purdue-orbital/balloon/boards/node_prototype/notes.md

# pending
- move ISP header away from relay
- keep ISP header close enough to power jumper so the jumper must be disconnected first
- fix regulator heatsink short
- break out radio serial to header
- disconnect reset pin on attiny84
