purdue-orbital/balloon/code/modem/simulation/modulation_coherent.png

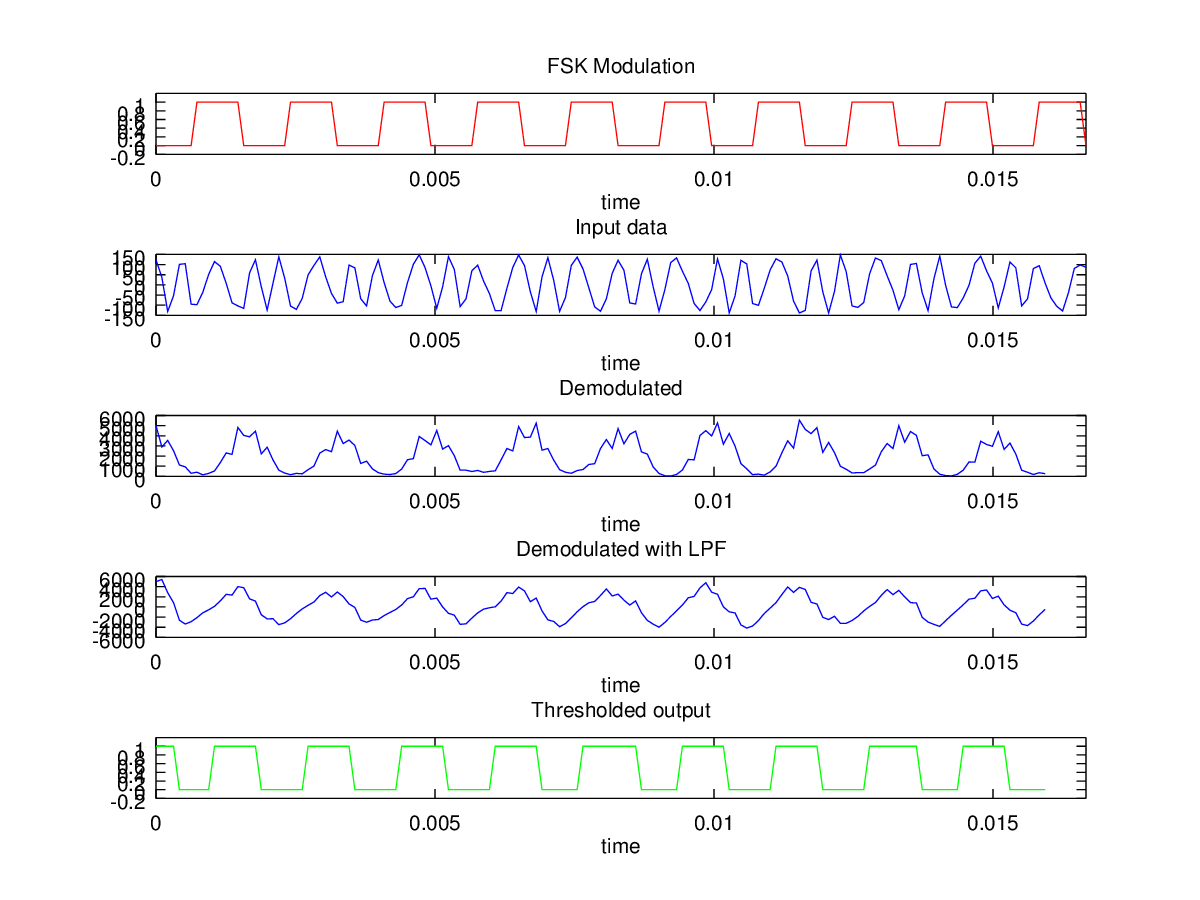
code/modem/simulation/modulation_coherent.png
