purdue-orbital/balloon/code/modem/simulation/modulation_coherent_noise5.png

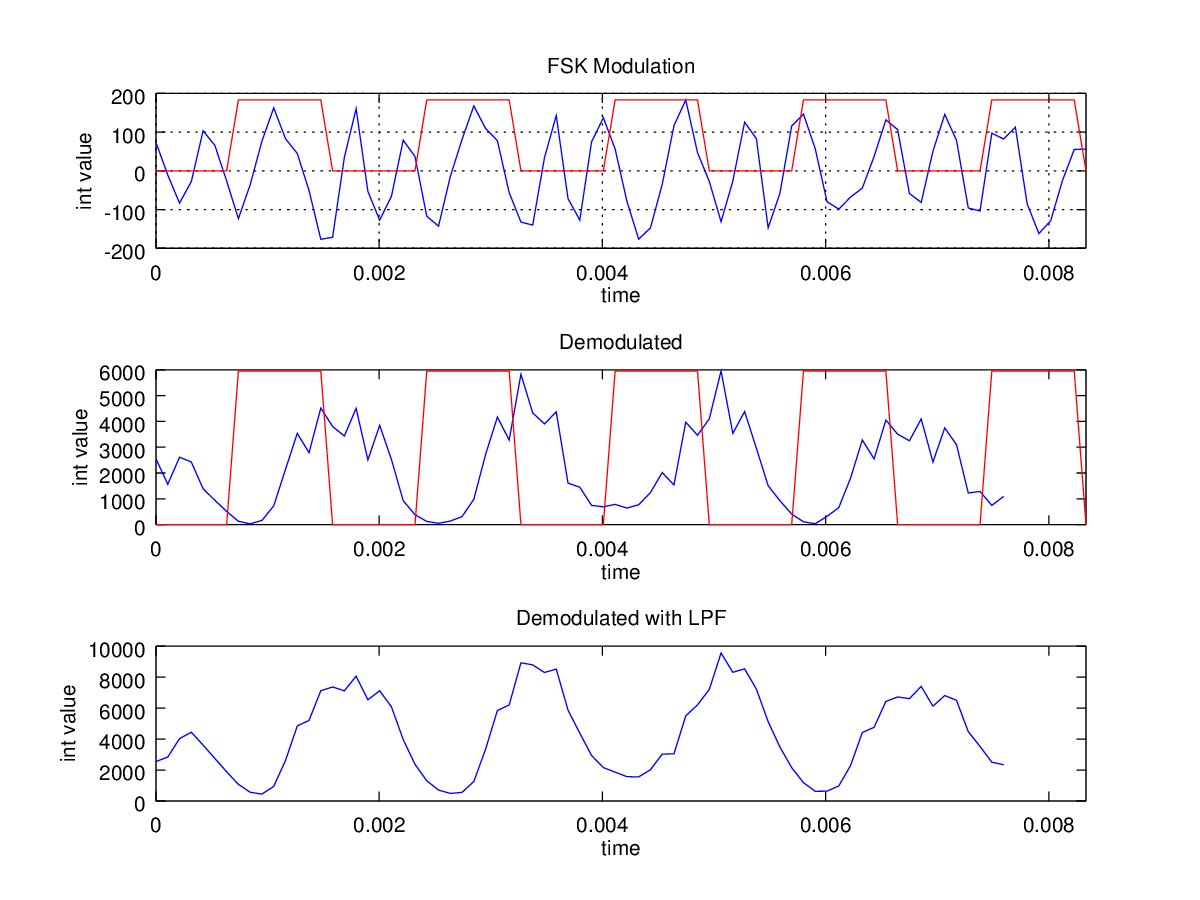
code/modem/simulation/modulation_coherent_noise5.png
