purdue-orbital/balloon/code/modem/simulation/modulation_coherent_noise25.png

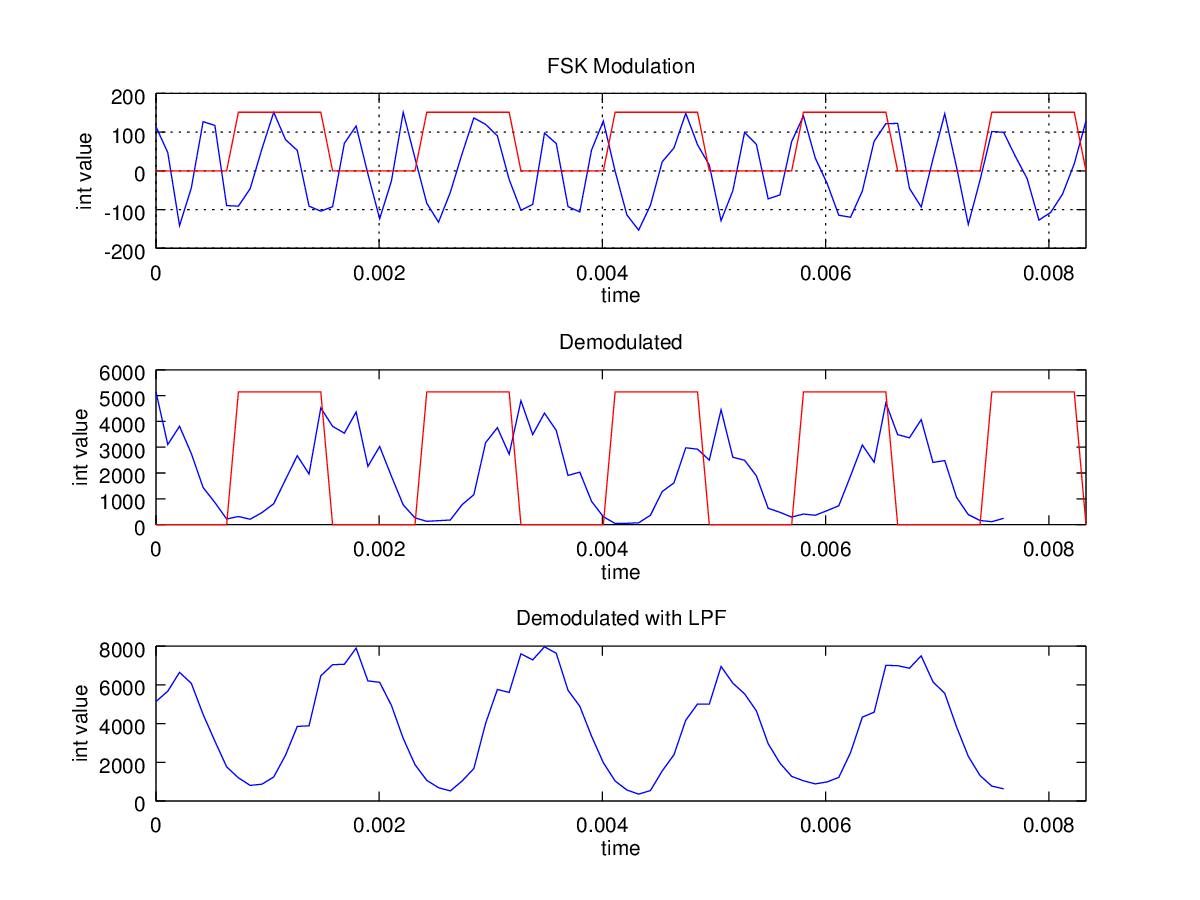
code/modem/simulation/modulation_coherent_noise25.png
