purdue-orbital/balloon/code/modem/simulation/modulation_incoherent.png

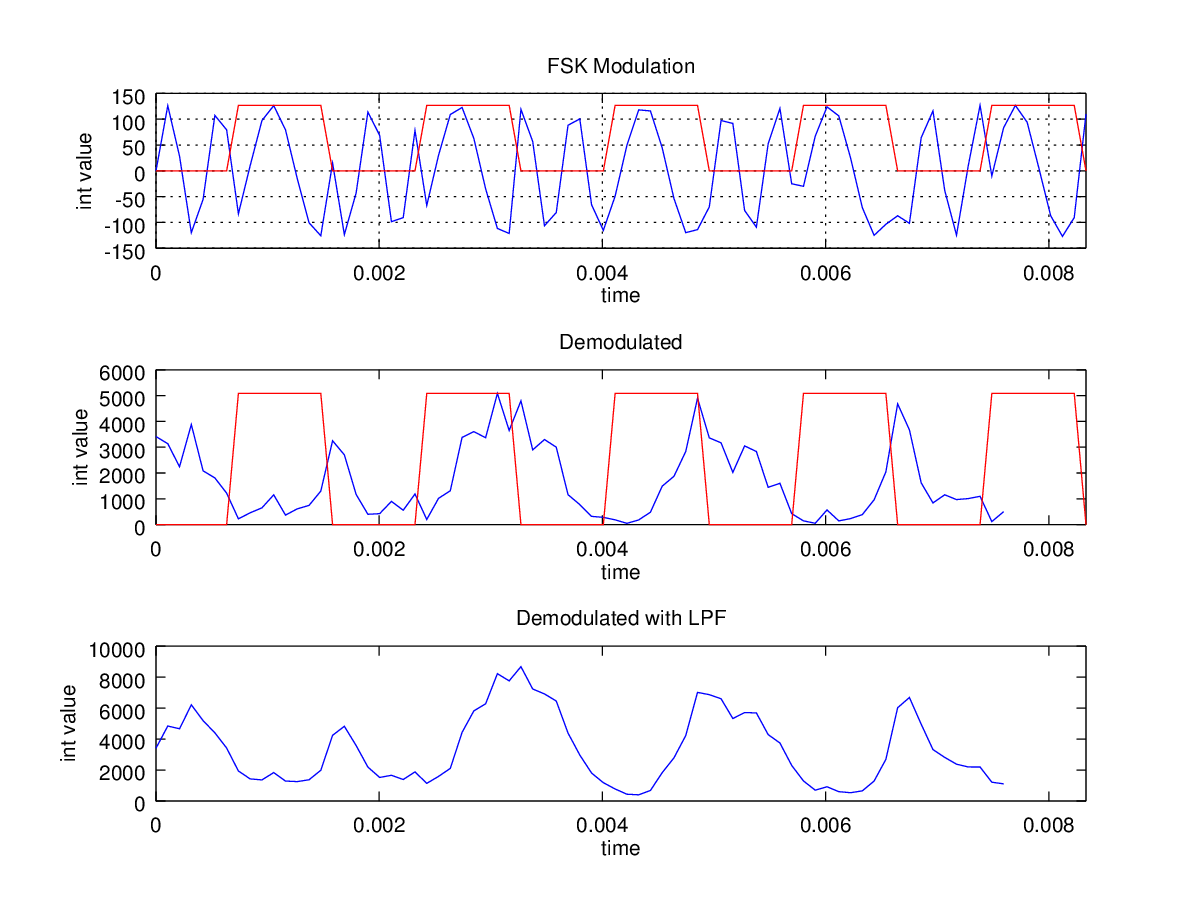
code/modem/simulation/modulation_incoherent.png
