purdue-orbital/balloon/code/modem/simulation/spectrogram_coherent.png

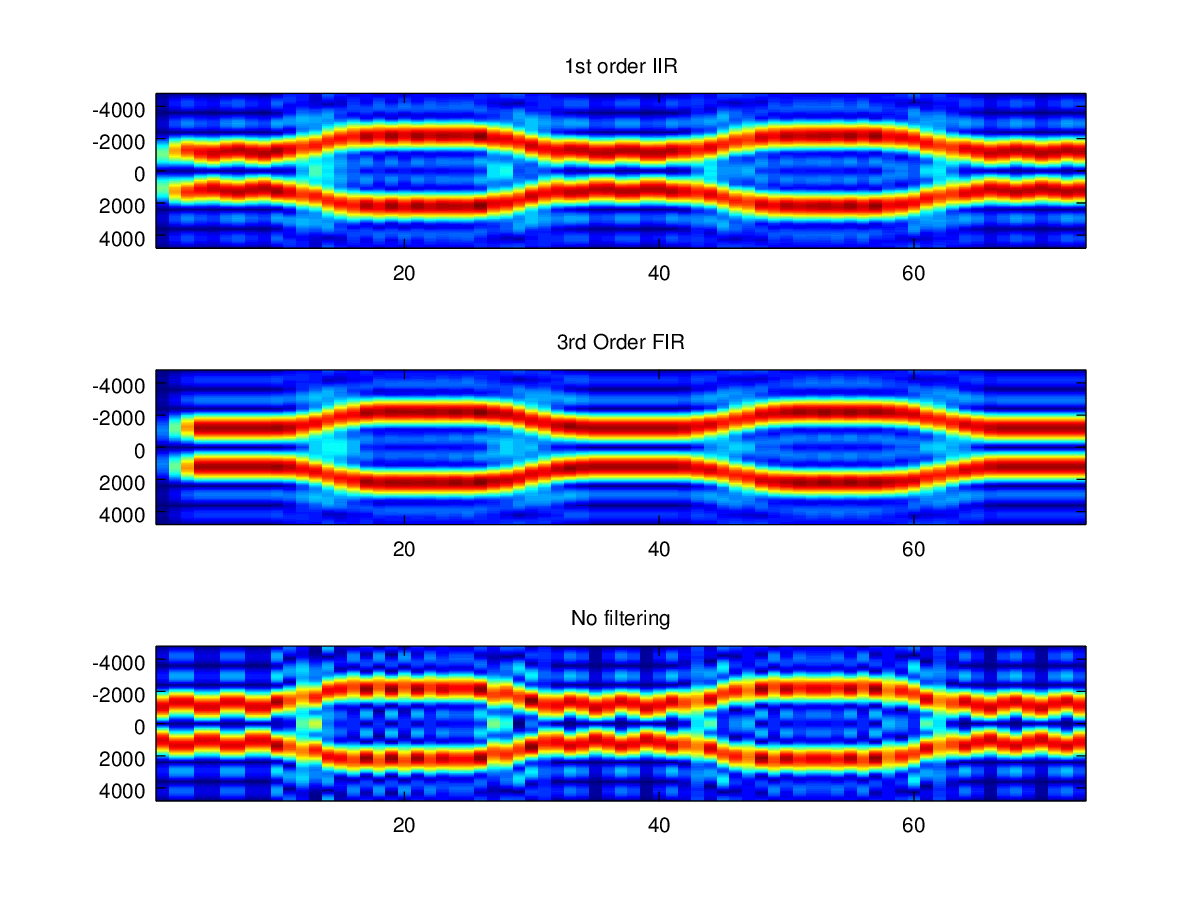
code/modem/simulation/spectrogram_coherent.png
