purdue-orbital/balloon/code/modem/simulation/spectrogram_incoherent.png

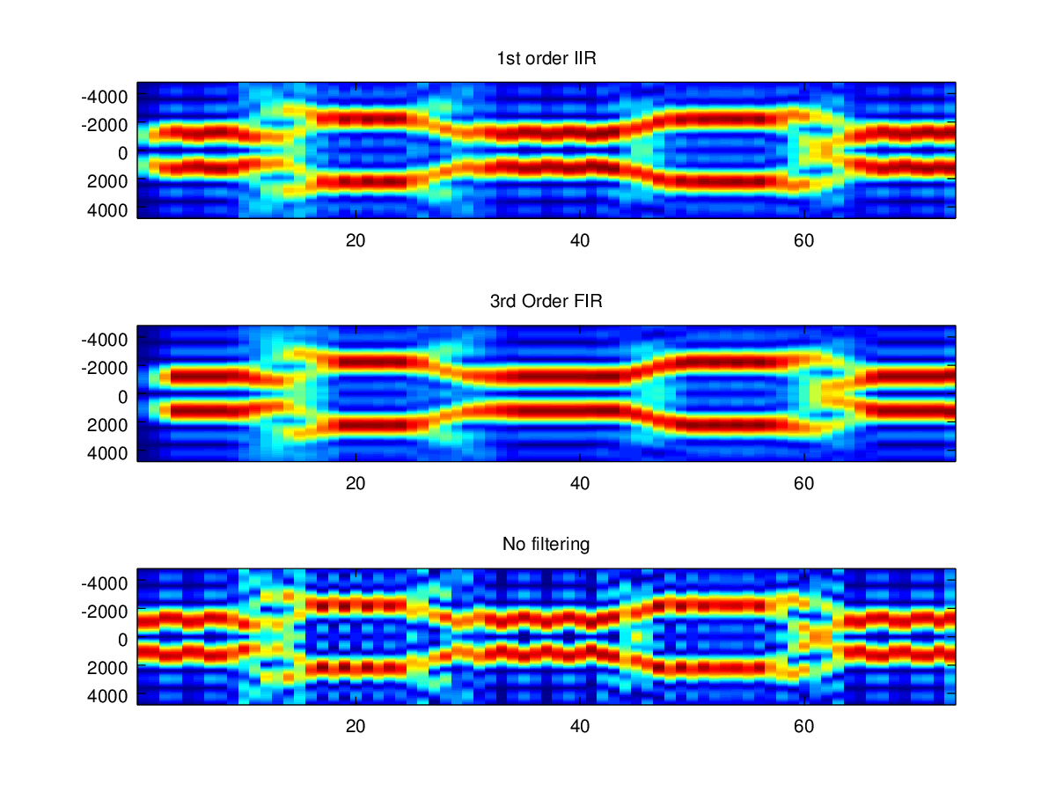
code/modem/simulation/spectrogram_incoherent.png
