purdue-orbital/balloon/boards/node_prototype/bom.md

| Part             | # Needed | # To Buy | Unit Cost | Link                                                                                                     |
|------------------+----------+----------+-----------+----------------------------------------------------------------------------------------------------------|
| ATTiny85         |        2 |        0 |           |                                                                                                          |
| 0.1uF            |        5 |        0 |           |                                                                                                          |
| 1uF              |        3 |        0 |           |                                                                                                          |
| 10uF             |        1 |        0 |           |                                                                                                          |
| DRA818V          |        1 |        0 |           |                                                                                                          |
| SMA Conn         |        1 |        0 |           |                                                                                                          |
| 2n2222           |        1 |        0 |           |                                                                                                          |
| Omron G5LE Relay |        1 |       10 |      1.41 | http://www.digikey.com/product-detail/en/omron-electronics-inc-emc-div/G5LE-1-ASI%20DC3/Z5213-ND/1815667 |
|                  |          |          |           |                                                                                                          |
