purdue-orbital/balloon/boards/node_prototype/node_prototype.brd

## EAGLE design boards/node_prototype/node_prototype.brd (2016-04-25)

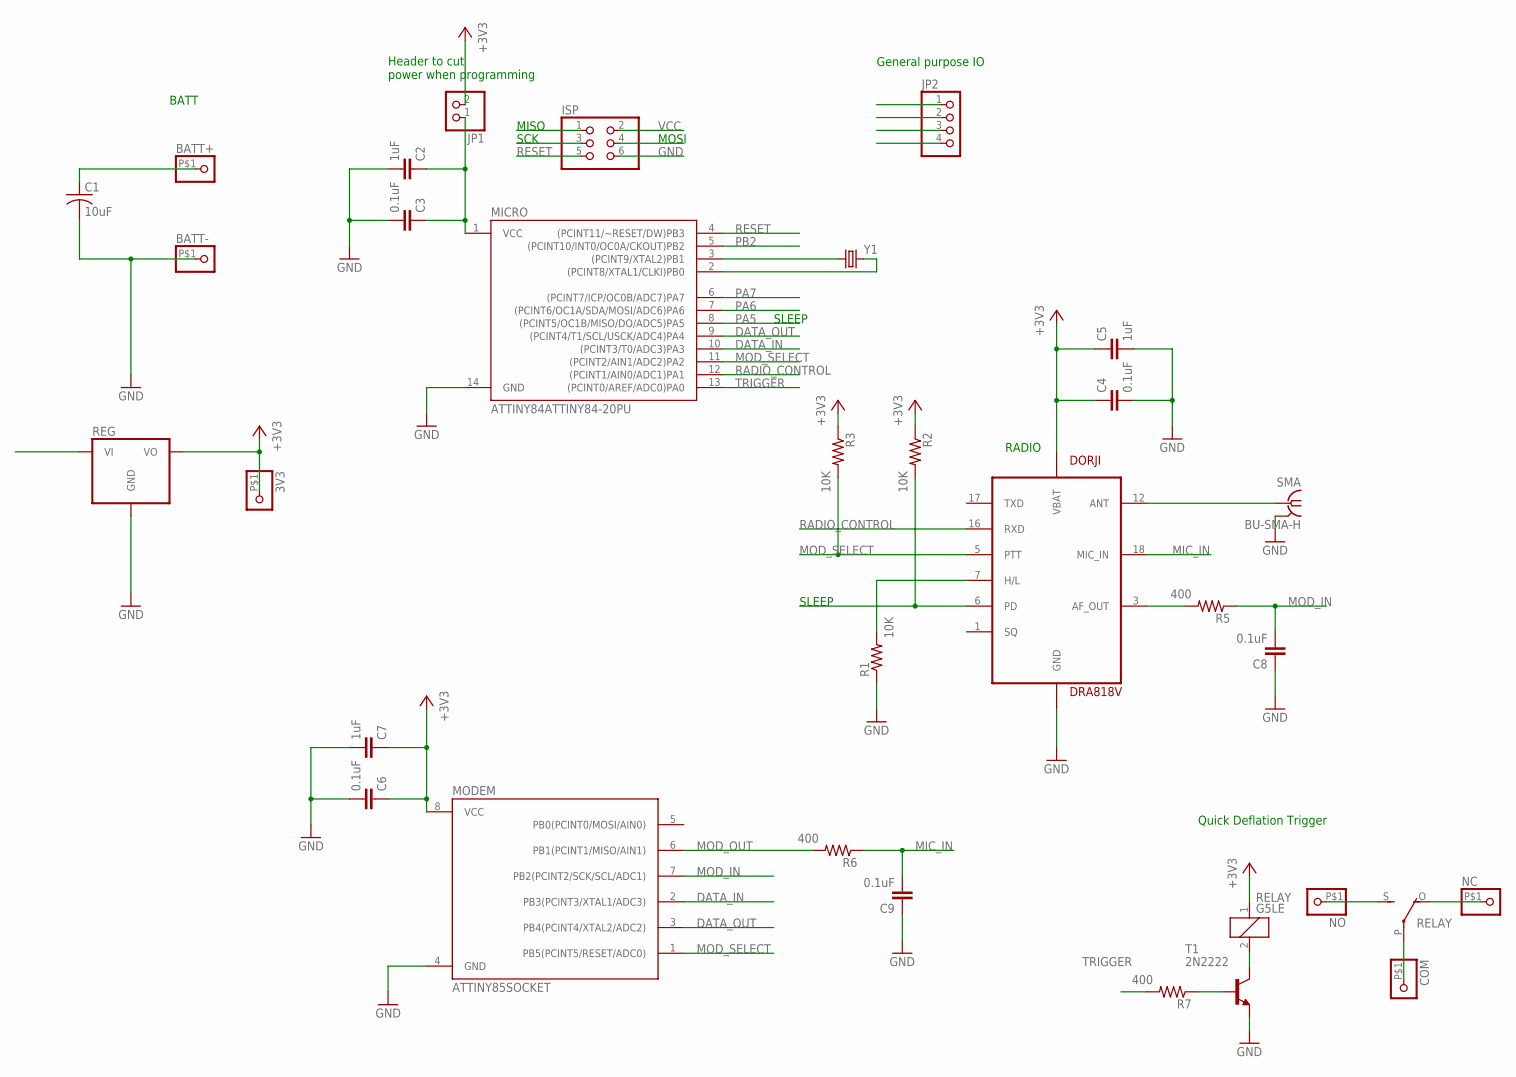
[picture p7: schematic node_prototype.sch]

Parts:
3V3: PINHD-1X1; 1X01
BATT+: PINHD-1X1; 1X01
BATT-: PINHD-1X1; 1X01
C1: 10uF; C025-050X050
C2, C5, C7: 1uF; C0603
C3, C4, C6, C8, C9: 0.1uF; C0603
COM: PINHD-1X1; 1X01
DORJI: DRA818V; DORJI
ISP: PINHD-2X3; 2X03
JP1: PINHD-1X2; 1X02
JP2: PINHD-1X4; 1X04
MICRO: ATTINY84ATTINY84-20PU; DIL14
MODEM: ATTINY85SOCKET; SOCKET-08
NC: PINHD-1X1; 1X01
NO: PINHD-1X1; 1X01
R1, R2, R3: 10K; R0603
R5, R6, R7: 400; R0603
REG: AP1117-3.3SOT223; SOT223
RELAY: G5LE
SMA: BU-SMA-H
T1: 2N2222; TO18
Y1: CRYSTAL; MYSMD2_RESONATOR

Connections:
+3V3: 3V3.P$1, C4.1, C5.1, C6.1, C7.1, DORJI.8 (VBAT), JP1.2, MODEM.8 (VCC), R2.1, R3.1, REG.2 (VO), REG.4 (VO), RELAY.1
BATT: BATT+.P$1, C1.1, REG.3 (VI)
DATA_IN: MICRO.10 ((PCINT3/T0/ADC3)PA3), MODEM.2 (PB3(PCINT3/XTAL1/ADC3))
DATA_OUT: ISP.3, MICRO.9 ((PCINT4/T1/SCL/USCK/ADC4)PA4), MODEM.3 (PB4(PCINT4/XTAL2/ADC2))
GND: BATT-.P$1, C1.2, C2.2, C3.2, C4.2, C5.2, C6.2, C7.2, C8.1, C9.1, DORJI.9 (GND), DORJI.10 (GND), ISP.6, MICRO.14 (GND), MODEM.4 (GND), R1.1, REG.1 (GND), SMA.2, SMA.3 (2), SMA.4 (2), SMA.5 (2), T1.1 (E)
MIC_IN: C9.2, DORJI.18 (MIC_IN), R6.1
MOD_IN: C8.2, MODEM.7 (PB2(PCINT2/SCK/SCL/ADC1)), R5.1
MOD_OUT: MODEM.6 (PB1(PCINT1/MISO/AIN1)), R6.2
MOD_SELECT: DORJI.5 (PTT), MICRO.11 ((PCINT2/AIN1/ADC2)PA2), MODEM.1 (PB5(PCINT5/RESET/ADC0)), R3.2
unnamed: DORJI.12 (ANT), SMA.1
unnamed: DORJI.7 (H/L), R1.2
unnamed: DORJI.3 (AF_OUT), R5.2
unnamed: R7.1, T1.2 (B)
unnamed: RELAY.2, T1.3 (C)
unnamed: MICRO.3 ((PCINT9/XTAL2)PB1), Y1.1
unnamed: NO.P$1, RELAY.S
unnamed: NC.P$1, RELAY.O
unnamed: COM.P$1, RELAY.P
unnamed: MICRO.2 ((PCINT8/XTAL1/CLKI)PB0), Y1.3 (2)
PA5: DORJI.6 (PD), ISP.1, JP2.4, MICRO.8 ((PCINT5/OC1B/MISO/DO/ADC5)PA5), R2.2
PA6: ISP.4, JP2.3, MICRO.7 ((PCINT6/OC1A/SDA/MOSI/ADC6)PA6)
PA7: JP2.2, MICRO.6 ((PCINT7/ICP/OC0B/ADC7)PA7)
PB2: JP2.1, MICRO.5 ((PCINT10/INT0/OC0A/CKOUT)PB2)
RADIO_CONTROL: DORJI.16 (RXD), MICRO.12 ((PCINT1/AIN0/ADC1)PA1)
RESET: ISP.5, MICRO.4 ((PCINT11/~RESET/DW)PB3)
TRIGGER: MICRO.13 ((PCINT0/AREF/ADC0)PA0), R7.2
VCC: C2.1, C3.1, ISP.2, JP1.1, MICRO.1 (VCC)

Notes on the sheet:
RADIO
BATT
SCK
MISO
MOSI
SLEEP
Header to cut power when programming
General purpose IO
Quick Deflation Trigger

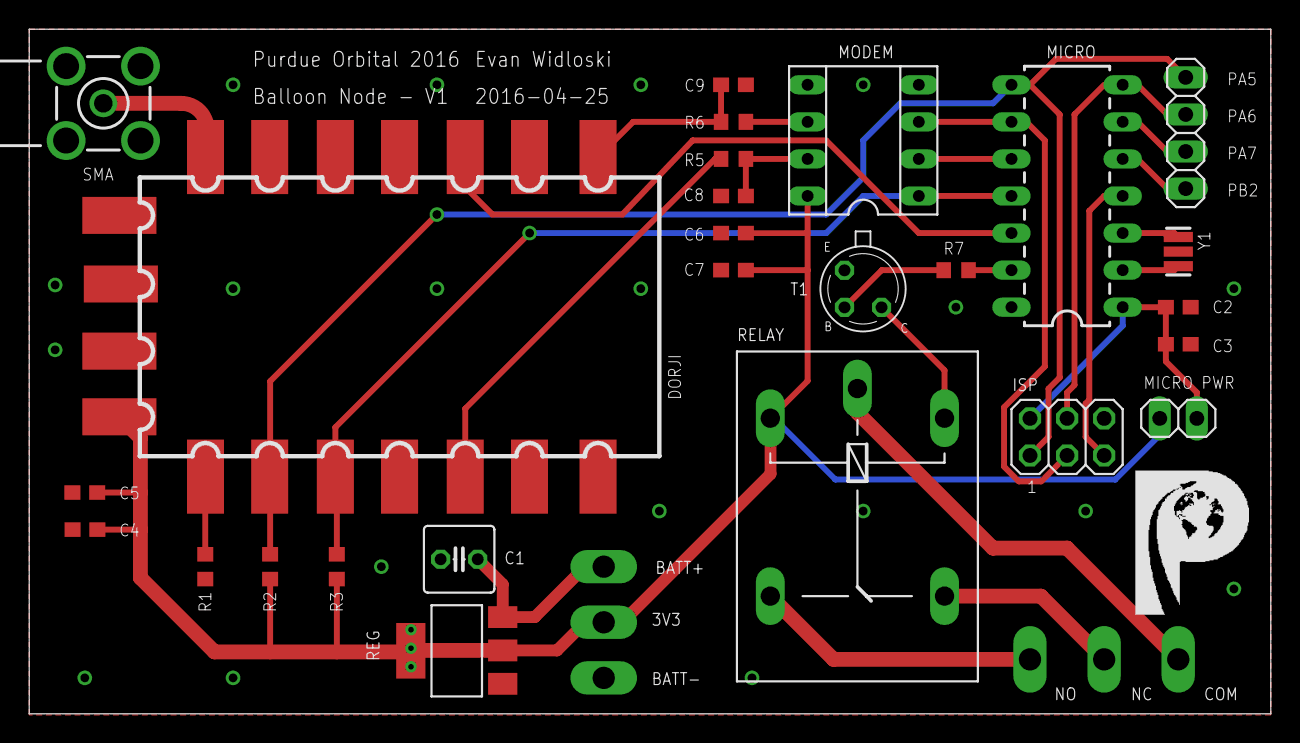
[picture p8: board node_prototype.brd from above]

Board: 2 copper layers, 85.1 x 46.9 mm, 32 parts (0 on the bottom side), 27 nets.
