purdue-orbital/balloon/(commit log)

2016-02-03 init comimt
    [rocketradio.brd, rocketradio.sch]
2016-02-03 init commit dos
    [rocketradio.brd, rocketradio.sch]
2016-02-03 moving to new repo
    [rocketradio.brd, rocketradio.sch]
2016-02-13 add timer test code
2016-03-02 update board with correct modem pinout
    [rocketradio.brd, rocketradio.sch]
2016-03-04 add micro
    [rocketradio.brd, rocketradio.sch]
2016-03-11 Added arduino master and slave code. WDT included but no timeouts yet.
2016-04-14 finish dumb node, update sims
    [rocketradio.brd, rocketradio.sch]
2016-04-23 use attiny84
    [rocketradio.brd, rocketradio.sch]
2016-04-25 update rocketradio board, complete
    [rocketradio.brd, rocketradio.sch]
2016-04-25 rename rocket radio, add renders
    [node_prototype.brd, node_prototype.sch, rocketradio.sch]
2017-02-19 Update master_nano.ino
    At first the arduinos appeared to stop sending serial data soon after beginning communication. Increasing baud rate of the serial between the two microcontrollers and controlling how often commands are sent seemed to stop any hangings that were experienced before the changes were made. This suggests that serial buffer overflow may be an issue that warrants some consideration in the design of the protocol.
    Fundamental changes to the protocol were made as well. The boards are now referred to as board 1 and board 2. They are differentiated from one another in software by reading the analog voltage input to A3 on the arduino mega. This pin is connected to a jumper on b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
    [master_nano.ino]
2017-04-05 one way communication with attention pin working
2017-04-09 full duplex with attention pin partially working
2017-04-09 Added Parsing of RX Data
    RX data is now parsed through parseRxData() which takes data from rxBuff[]. Still need to integrate buffer and duplex spi code.
2017-04-12 Update UI_Arduino.c
    *** Created the following cases for Act On User: go and stop (for control of 1st DOF)
    *** Filled in loop() function so that arduino waits for input of % followed by command character, then calls talk() if there is data to send or receive
    *** talk() command now calls parseRxData before returning, if there is rxData in buffer to process rx data. NOTE: May interrupt user command inputs
    *** Set ATTENTION_OUT high after every end of transmission stream in talk(). This assumes the buffer will always be completely emptied in talk(). Every time addTxBuff() is called, the ATTENTION_OUT pin is set low.
    *** Flaw in parseRxData requires transmission of '@' at end of every trans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
2017-04-12 partial master code switch-over
2017-04-13 Updated parseRxData()
    Following updates to parseRxData()
    *** Fixed flaw where '@' was required at end of stream of incoming data for data to be parsed properly. '@' can now be used purely as a start delimeter (can also represent data as they could in the past) (TESTED)
    *** parseRxData() no longer requires the entire packets to be added to the rxBuff[]. parseRxData() will now automatically shift and save a partial packet if one is encountered at the end of the logical rxBuff[] array. (TESTED)
    *** parseRxData() should now be ok with interrupts occurring during it's execution. Any new data added during the execution of parseRxData() is ignored. The lines of code that shift the data in the rx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
    [UI_Arduino.c]
2017-04-15 Updated & Tested writeData
    *** writeData now uses the legacy Tx request frame type
    *** writeData accepts a variable payload in the form of an array and requires length of payload as the 2nd parameter.
    *** TESTED writeData, success!
2017-04-15 Receiving Functions Update and Test
    ***defines were updated, and a method of testing receiving of radio packets was placed , commented out, in void loop()
    ***radRxBuff and supporting functions created for data coming in from radio, ardTxBuff and supporting functions created for data being sent to arduino (only TESTED radRxBuff & supporting functions)
    ***Replaced extractRadPackets with parseRadData and TESTED, however..... WARNING: PAYLOADS OF 6 BYTES DO NOT WORK FOR SOME REASON, NOT SURE IF THE ISSUE IS SENDING OR RECEVING, FOR NOW PAYLOAD WILL BE 7 BYTES
    ***Added printArray to quickly debug future problems by passing printArray the address of the first array element to be printed and the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
    [Radio_Master.c]
